xdylanm/adsr-eg/README.md

# ADSR Envelope Generator

An envelope generator modeled on the 555-based ADSR originally proposed by Jonathan Jacky. It's worth looking through the evolution of this design - see documentation.
