xdylanm/adsr-eg/docs/assets/images/block_diagram_1.png

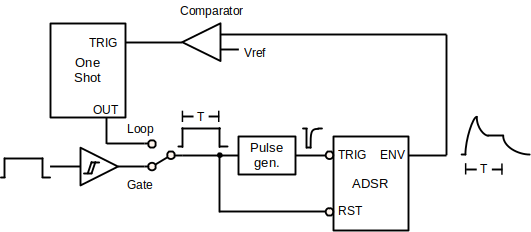
docs/assets/images/block_diagram_1.png
