xdylanm/adsr-eg/docs/assets/schematic.pdf

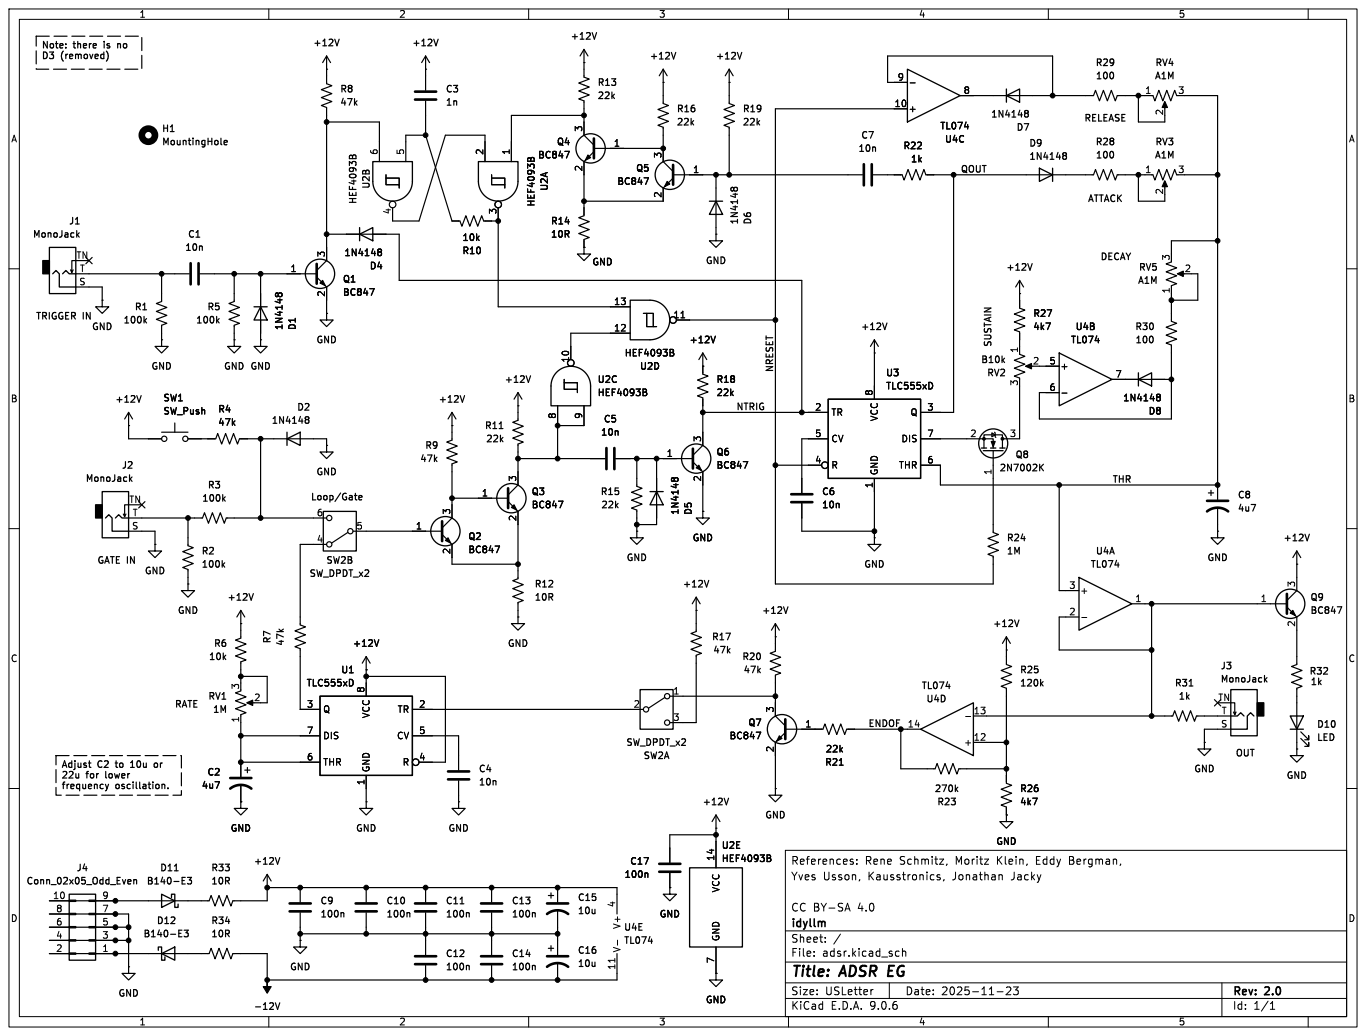
[picture p16: page 1]

Note: there is no D3 (removed)

ENDOF Adjust C2 to 10u or 22u for lower

idyllm
File: adsr.kicad_sch Sheet: /
Id: 1/1 Title: ADSR EG
