xdylanm/adsr-eg/hardware/adsr/adsr.kicad_pcb

## KiCad design hardware/adsr/adsr.kicad_pcb (2025-12-27)

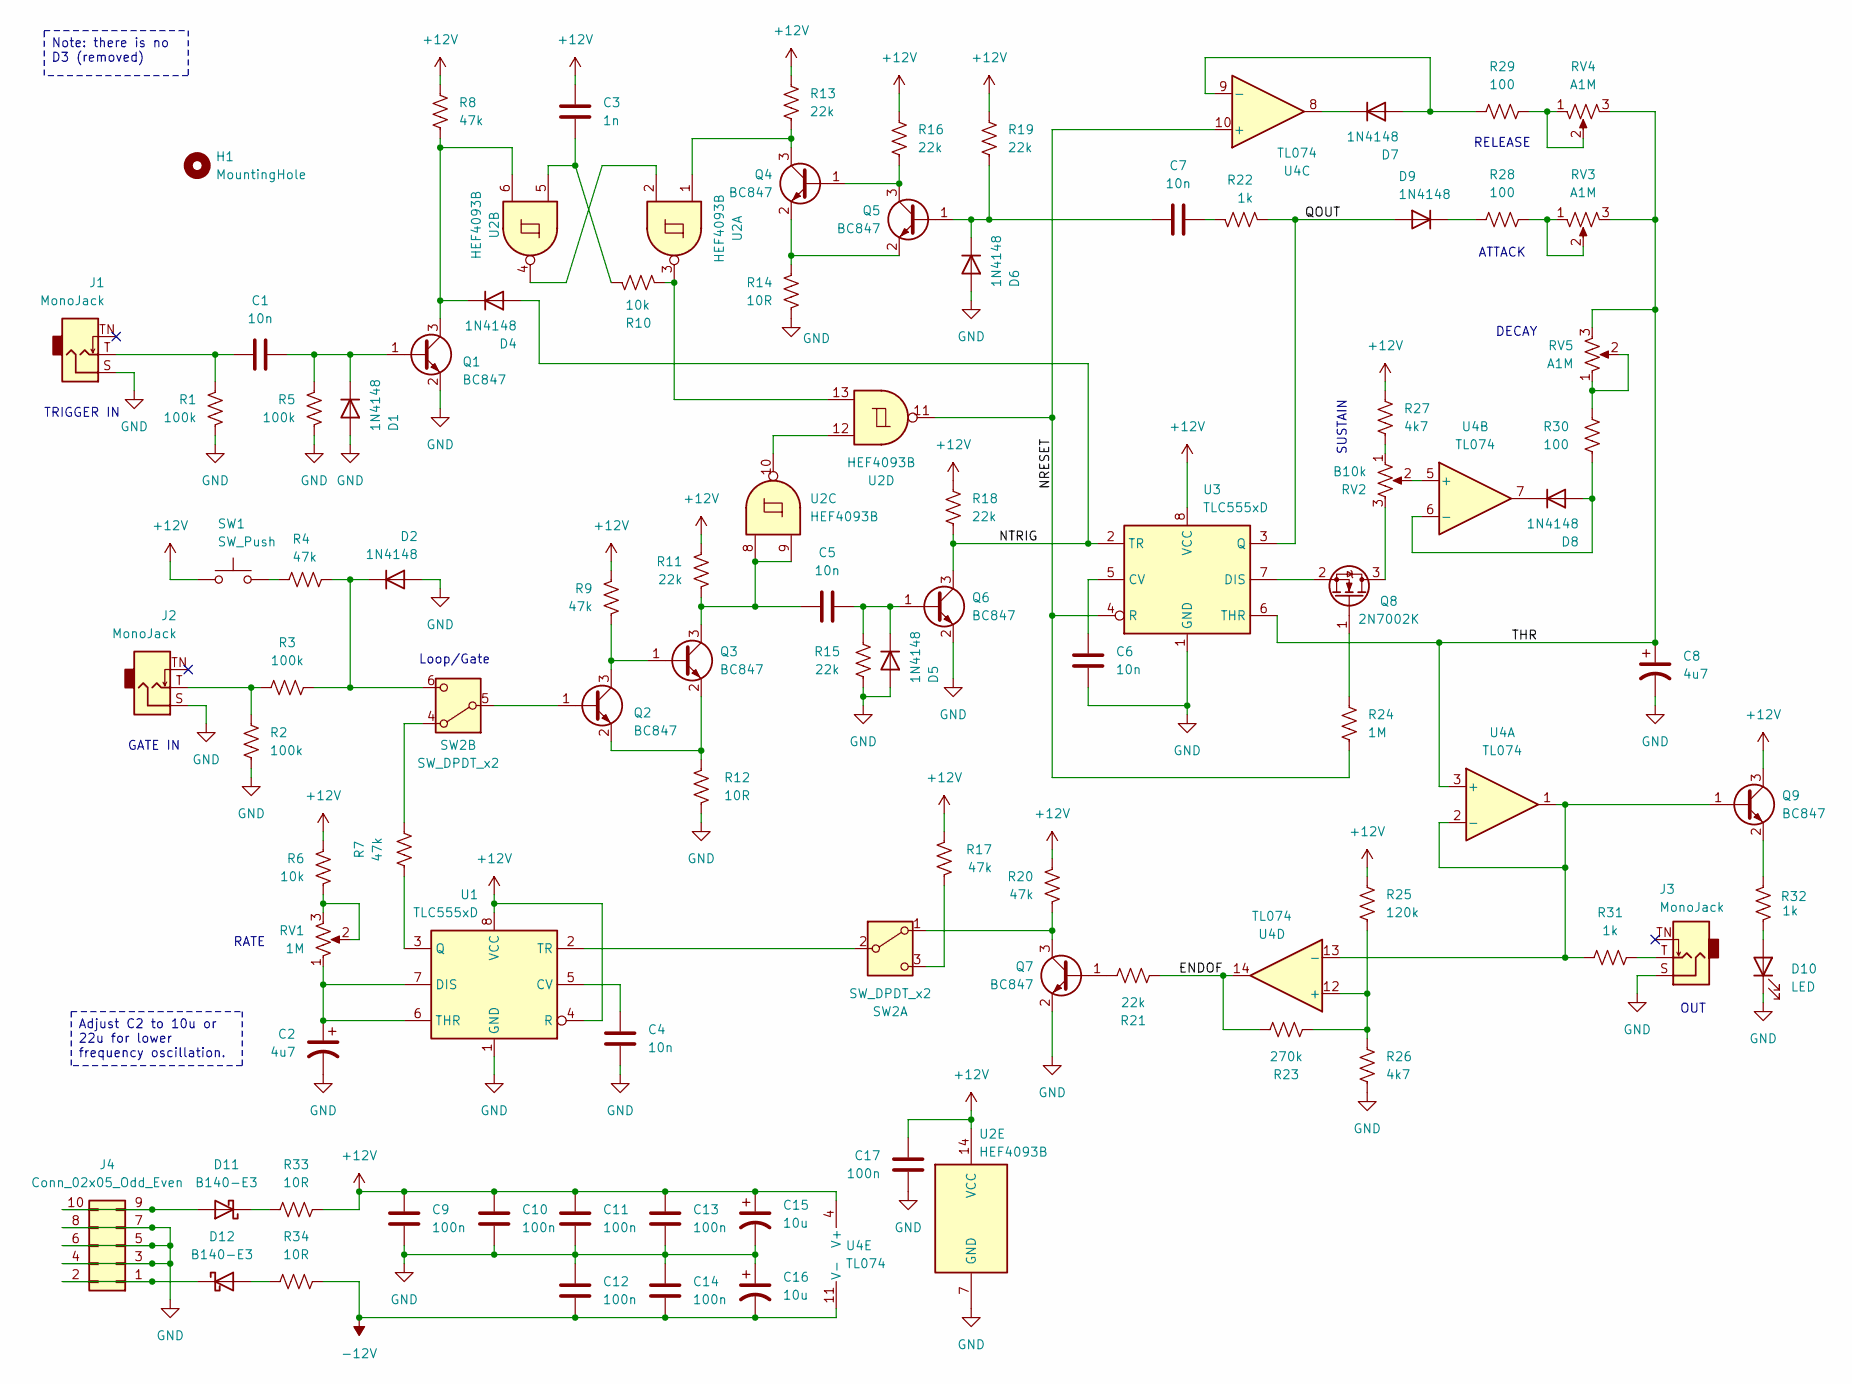
[picture p17: schematic adsr.kicad_sch, ADSR EG]

Parts:
C1, C4, C5, C6, C7: 10n; C_0805_2012Metric_Pad1.18x1.45mm_HandSolder
C2, C8: 4u7; CP_EIA-3216-18_Kemet-A_HandSolder
C3: 1n; C_0805_2012Metric_Pad1.18x1.45mm_HandSolder
C9, C10, C11, C12, C13, C14, C17: 100n; C_0805_2012Metric_Pad1.18x1.45mm_HandSolder
C15, C16: 10u; CP_Radial_D5.0mm_P2.50mm
D1, D2, D4, D5, D6, D7, D8, D9: 1N4148; D_SOD-123
D10: LED; LED_D3.0mm
D11, D12: B140-E3; D_SMA
H1: MountingHole; MountingHole_3.2mm_M3_DIN965
J1, J2, J3: MonoJack; Jack_3.5mm_QingPu_WQP-PJ301M-12_Vertical
J4: Conn_02x05_Odd_Even; IDC-Header_2x05_P2.54mm_Vertical
Q1, Q2, Q3, Q4, Q5, Q6, Q7, Q9: BC847; SOT-23
Q8: 2N7002K; SOT-23
R1, R2, R3, R5: 100k; R_0805_2012Metric_Pad1.20x1.40mm_HandSolder
R4, R7, R8, R9, R17, R20: 47k; R_0805_2012Metric_Pad1.20x1.40mm_HandSolder
R6, R10: 10k; R_0805_2012Metric_Pad1.20x1.40mm_HandSolder
R11, R13, R15, R16, R18, R19, R21: 22k; R_0805_2012Metric_Pad1.20x1.40mm_HandSolder
R12, R14, R33, R34: 10R; R_0805_2012Metric_Pad1.20x1.40mm_HandSolder
R22, R31, R32: 1k; R_0805_2012Metric_Pad1.20x1.40mm_HandSolder
R23: 270k; R_0805_2012Metric_Pad1.20x1.40mm_HandSolder
R24: 1M; R_0805_2012Metric_Pad1.20x1.40mm_HandSolder
R25: 120k; R_0805_2012Metric_Pad1.20x1.40mm_HandSolder
R26, R27: 4k7; R_0805_2012Metric_Pad1.20x1.40mm_HandSolder
R28, R29, R30: 100; R_0805_2012Metric_Pad1.20x1.40mm_HandSolder
RV1: 1M; Potentiometer_Bourns_PTV09A-1_Single_Vertical_thin
RV2: B10k; Potentiometer_Bourns_PTV09A-1_Single_Vertical_thin
RV3, RV4, RV5: A1M; Potentiometer_Bourns_PTV09A-1_Single_Vertical_thin
SW1: SW_Push; SW_PUSH_6mm
SW2: SW_DPDT_x2; SW_Dailywell_DPDT_2MD1T1B1M1
U1, U3: TLC555xD; SOIC-8_3.9x4.9mm_P1.27mm
U2: HEF4093B; SOIC-14_3.9x8.7mm_P1.27mm
U4: TL074; SOIC-14_3.9x8.7mm_P1.27mm

Connections:
+12V: C3.2, C9.2, C10.2, C11.2, C13.2, C15.1, C17.2, Q9.3 (C), R6.1, R8.2, R9.2, R11.1, R13.1, R16.1, R17.1, R18.1, R19.1, R20.1, R25.2, R27.1, R33.2, SW1.2, U1.4 (R), U1.8 (VCC), U2.14 (VCC), U3.8 (VCC), U4.4 (V+)
-12V: C12.1, C14.1, C16.2, R34.2, U4.11 (V-)
/ENDOF: R21.2, R23.2, U4.14
/NRESET: R24.2, U2.11, U3.4 (R), U4.10 (+)
/NTRIG: D4.2 (A), Q6.3 (C), R18.2, U3.2 (TR)
/QOUT: D9.2 (A), R22.2, U3.3 (Q)
/THR: C8.1, RV3.3, RV4.3, RV5.3, U3.6 (THR), U4.3 (+)
GND: C2.2, C4.1, C6.1, C8.2, C9.1, C10.1, C11.1, C12.2, C13.1, C14.2, C15.2, C16.1, C17.1, D1.2 (A), D2.2 (A), D5.2 (A), D6.2 (A), D10.1 (K), J1.S, J2.S, J3.S, J4.3, J4.4, J4.5, J4.6, J4.7, J4.8, Q1.2 (E), Q6.2 (E), Q7.2 (E), R1.1, R2.1, R5.1, R12.2, R14.1, R15.2, R26.1, U1.1 (GND), U2.7 (GND), U3.1 (GND)
unnamed: C1.2, J1.T, R1.2
unnamed: C3.1, R10.2, U2.5
unnamed: C7.1, R22.1
unnamed: C1.1, D1.1 (K), Q1.1 (B), R5.2
unnamed: D2.1 (K), R3.2, R4.1, SW2.6 (C)
unnamed: D4.1 (K), Q1.3 (C), R8.1, U2.6
unnamed: C5.1, D5.1 (K), Q6.1 (B), R15.1
unnamed: C7.2, D6.1 (K), Q5.1 (B), R19.2
unnamed: D7.2 (A), R29.1, U4.9 (-)
unnamed: D7.1 (K), U4.8
unnamed: D8.2 (A), R30.1, U4.6 (-)
unnamed: D8.1 (K), U4.7
unnamed: D9.1 (K), R28.1
unnamed: D10.2 (A), R32.1
unnamed: D11.2 (A), J4.9, J4.10
unnamed: D11.1 (K), R33.1
unnamed: D12.2 (A), R34.1
unnamed: D12.1 (K), J4.1, J4.2
unnamed: J2.T, R2.2, R3.1
unnamed: J3.T, R31.2
unnamed: Q2.1 (B), SW2.5 (B)
unnamed: Q2.3 (C), Q3.1 (B), R9.1
unnamed: Q2.2 (E), Q3.2 (E), R12.1
unnamed: C5.2, Q3.3 (C), R11.2, U2.8, U2.9
unnamed: Q4.1 (B), Q5.3 (C), R16.2
unnamed: Q4.3 (C), R13.2, U2.1
unnamed: Q4.2 (E), Q5.2 (E), R14.2
unnamed: Q7.1 (B), R21.1
unnamed: Q7.3 (C), R20.2, SW2.1 (A)
unnamed: Q8.3 (D), RV2.3
unnamed: Q8.1 (G), R24.1
unnamed: Q8.2 (S), U3.7 (DIS)
unnamed: Q9.1 (B), R31.1, U4.1, U4.2 (-), U4.13 (-)
unnamed: Q9.2 (E), R32.2
unnamed: R4.2, SW1.1
unnamed: R6.2, RV1.2, RV1.3
unnamed: R10.1, U2.3, U2.13
unnamed: R27.2, RV2.1
unnamed: R28.2, RV3.1, RV3.2
unnamed: R29.2, RV4.1, RV4.2
unnamed: R30.2, RV5.1, RV5.2
unnamed: SW2.2 (B), U1.2 (TR)
unnamed: R17.2, SW2.3 (C)
unnamed: R7.1, SW2.4 (A)
unnamed: C4.2, U1.5 (CV)
unnamed: C2.1, RV1.1, U1.6 (THR), U1.7 (DIS)
unnamed: R7.2, U1.3 (Q)
unnamed: U2.2, U2.4
unnamed: U2.10, U2.12
unnamed: C6.2, U3.5 (CV)
unnamed: RV2.2, U4.5 (+)
unnamed: R23.1, R25.1, R26.2, U4.12 (+)

Notes on the sheet:
OUT
Loop/Gate
ATTACK
GATE IN
RELEASE
RATE
SUSTAIN
TRIGGER IN
DECAY
Adjust C2 to 10u or 22u for lower frequency oscillation.
Note: there is no D3 (removed)

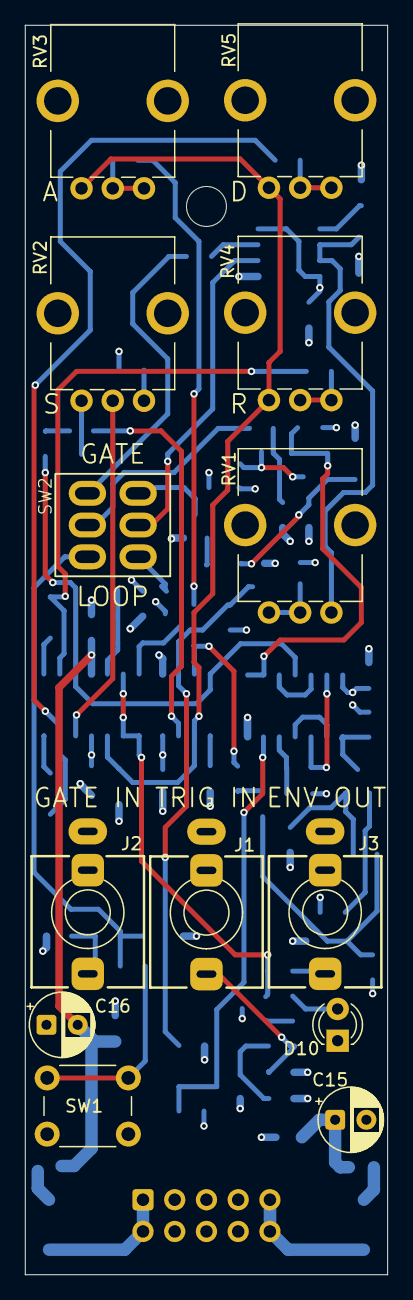
[picture p18: board adsr.kicad_pcb from above]

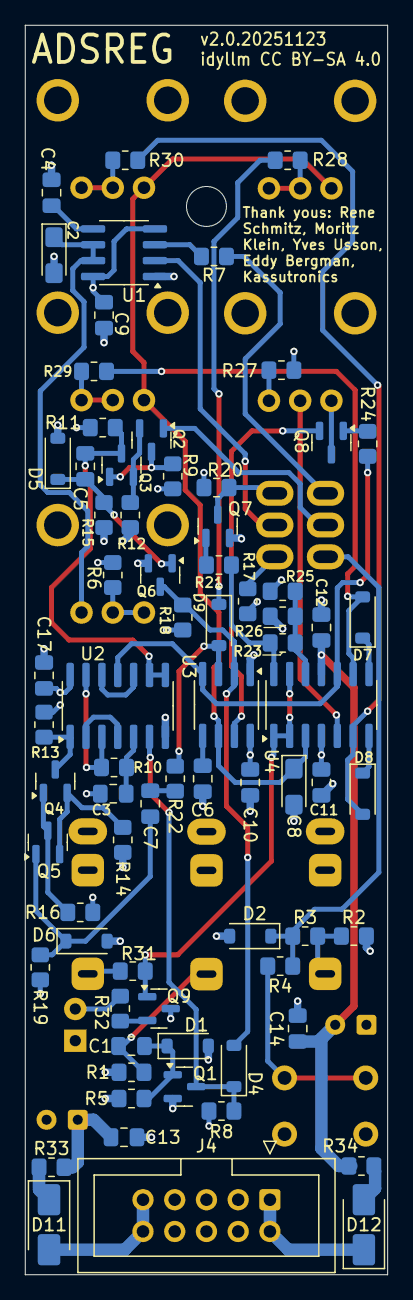
[picture p19: board adsr.kicad_pcb from below]

Board: 4 copper layers, 29.0 x 100.0 mm, 87 parts (73 on the bottom side), 60 nets.
