xdylanm/adsr-eg/(commit log)

2025-09-16 Put debug LED code behind an ifdef, changed timing to 8ms-2s range
2025-09-18 v1 dual gate delay PCB
    [dual-gate-delay.kicad_pcb, dual-gate-delay.kicad_sch]
2025-09-28 Initial hardware design for ADSR EG, verified on breadboard.
    [adsr.kicad_pcb, adsr.kicad_sch]
2025-09-28 Moved gate delay to a separate repo, removing from ADSR
    [dual-gate-delay.kicad_pcb, dual-gate-delay.kicad_sch]
2025-09-29 Added missing gate R on MOSFET
    [adsr.kicad_pcb, adsr.kicad_sch]
2025-09-30 added mechanical hole and final silk cleanup
    [adsr.kicad_pcb, adsr.kicad_sch]
2025-10-21 Migrate to mkdocs/material (#1)
    * Conversion to mkdocs/material for documentation
    * Added block diagram
2025-11-13 V1 build (#2)
    Build and validation notes for the v1.0 PCB
2025-12-27 Feat/external trigger (#3)
    * Committing WIP on ADSR with trigger: Falstad circuit & schematic, some changes to the KiCAD schematic
    * schematic built and tested on breadboard
    * added schematic screenshot from Falstad and updated the simulation circuit (link)
    * routed PCB, needs cleanup
    * routing cleanup
    * clean up silk, check board, generate gerbers for v2
    * Updated documentation for trigger input
    * Updated BOM
    * Updated assembly guide after assembling and testing two boards. Added annotations to schematic.
    * Faceplate with art. Tested with 3DP and printouts. Adjustments marked on layout.
    * Clean up and regenerate schematic.pdf (out of date before)
    [adsr.kicad_pcb, adsr.kicad_sch, bom.csv, faceplate.kicad_pcb, faceplate.kicad_sch]
