xdylanm/adsr-eg/(notices)

Notices in the files:
hardware/adsr/adsr.kicad_pcb:
CC BY-SA 4.0
idyllm CC BY-SA 4.0
